tfg13/ringcube/(list of files, drawings)

Other design files:
main_circuit.fzz
