tfg13/ringcube/(commit log)

2014-06-01 main circuit, prelimary version
    [main_circuit.fzz]
2014-06-01 case still some internal supports missing
    [case.FCStd]
2014-06-01 pin configuration for prelimary circuit
2014-07-02 hardware done, software working in parts. can be used as watch now
    [case.FCStd, main_circuit.fzz, main_circuit_recover.fzz]
2014-07-05 switched to direct use of updated sdfatlib arduinos sd lib somehow cannot handle card re-initialization after sleep
2014-07-10 fix: do not ring on first light press after alarm was disabled
    [power.h, timers.h]
2014-07-22 re-arranged some power settings. should not have any impact on power consumption
2014-07-22 fixed bug in setting the alarm time that could lead to invalid settings for the hour
    [menus.h]
2014-08-11 correctly power up rtc on wakeup
    [power.h]
2014-08-11 fixed a problem where the time from dcf was 1 second off
    [dcf.h]
2014-08-11 gracefully wake SD card up, respect that SPI must be turned on AFTER power
2014-09-14 measure + display supply voltage
2014-09-14 diag: reset all status & control registers with new api call
    [diag.h]
2014-09-14 removed old files
    [case.FCStd, main_circuit_recover.fzz]
2014-09-14 simplified solar circuit
    [main_circuit.fzz]
2014-09-30 remove toggle menu, just toggle alarm when button is pressed
2014-09-30 press middle button for 1 second to enable alarm and set it to +8 hours
2014-09-30 implemented advanced snoozing logic
    - saves original alarm time and restores it once snoozing is done
    - snooze must be disabled before entering main menu (should fix all sorts of corner cases)
    [ringcube.ino]
2014-10-17 debounce light button press on snooze
2015-02-26 fixed major power surge, should run on solar power forever now
    [main_circuit.fzz]
2015-11-06 fixed typo in diag code
    [diag.h]
2015-11-08 cc4 license (circuit, case)
